RUTMIIT/hackathon/3D/STEP_ROS/уголок.stp

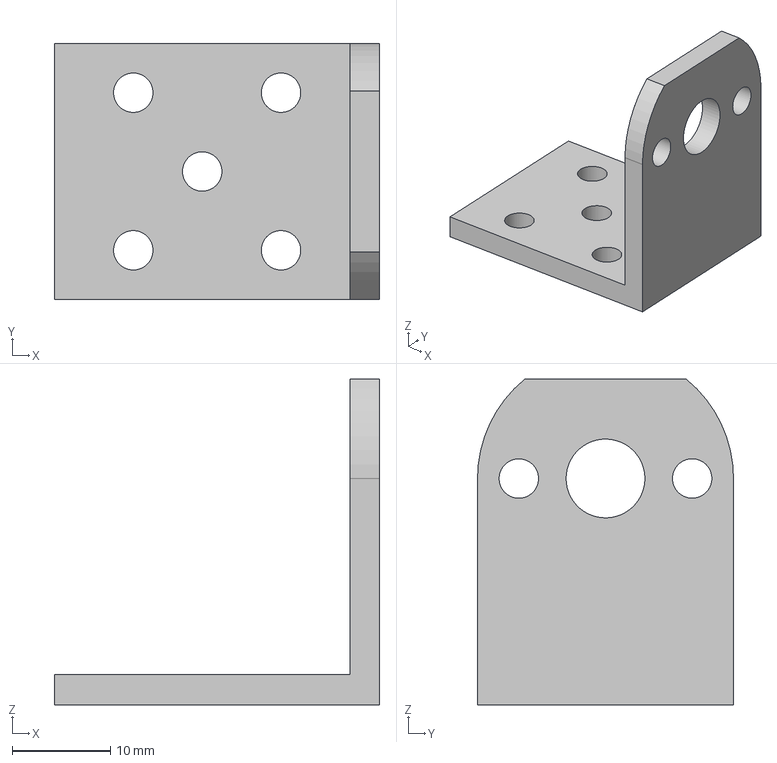
[picture p12: CAD file, 2025-04-05]
3D/STEP_ROS/уголок.stp
33.0 x 26.0 x 33.1 mm
