RUTMIIT/hackathon/3D/STEP_ROS/Сервопривод mg996r.stp

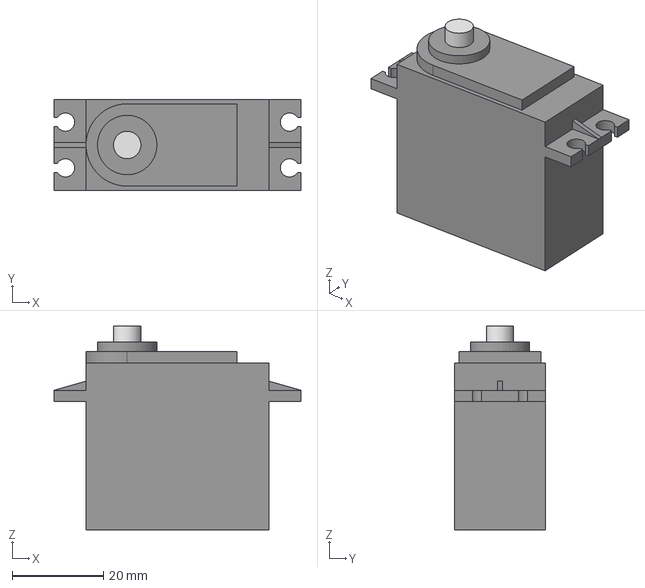
[picture p13: CAD file, 2025-04-05]
3D/STEP_ROS/Сервопривод mg996r.stp
54.0 x 20.0 x 44.5 mm
