RUTMIIT/hackathon/3D/STEP_ROS/Проставка 20 мм.stp

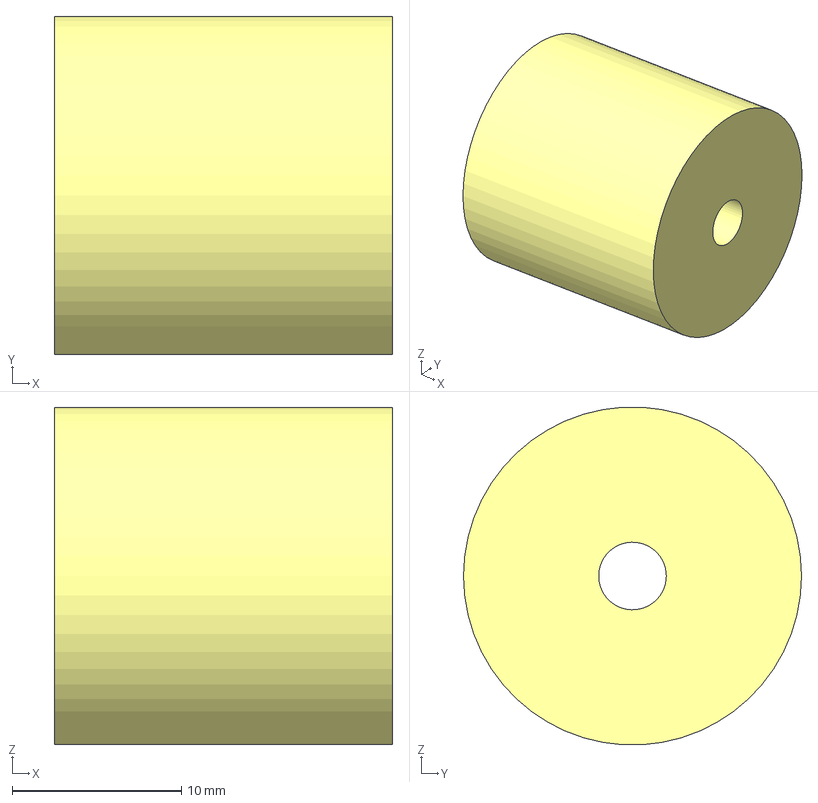
[picture p14: CAD file, 2025-04-05]
3D/STEP_ROS/Проставка 20 мм.stp
20.0 x 20.0 x 20.0 mm
