RUTMIIT/hackathon/3D/STEP_ROS/Кронштейн сервопривода вращения.stp

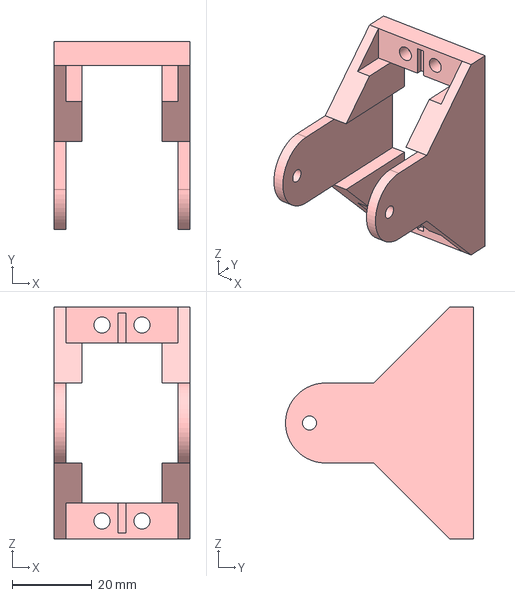
[picture p15: CAD file, 2025-04-05]
3D/STEP_ROS/Кронштейн сервопривода вращения.stp
34.0 x 47.0 x 58.0 mm
