RUTMIIT/hackathon/3D/STEP_ROS/Проставка 8 мм X2.stp

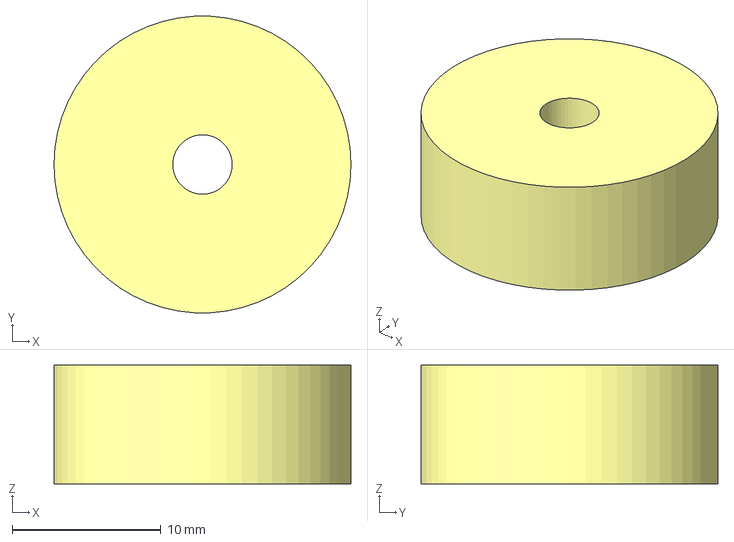
[picture p16: CAD file, 2025-04-05]
3D/STEP_ROS/Проставка 8 мм X2.stp
20.0 x 20.0 x 8.00 mm
