RUTMIIT/hackathon/3D/STEP_ROS/Кронштейн серво-станина X2.stp

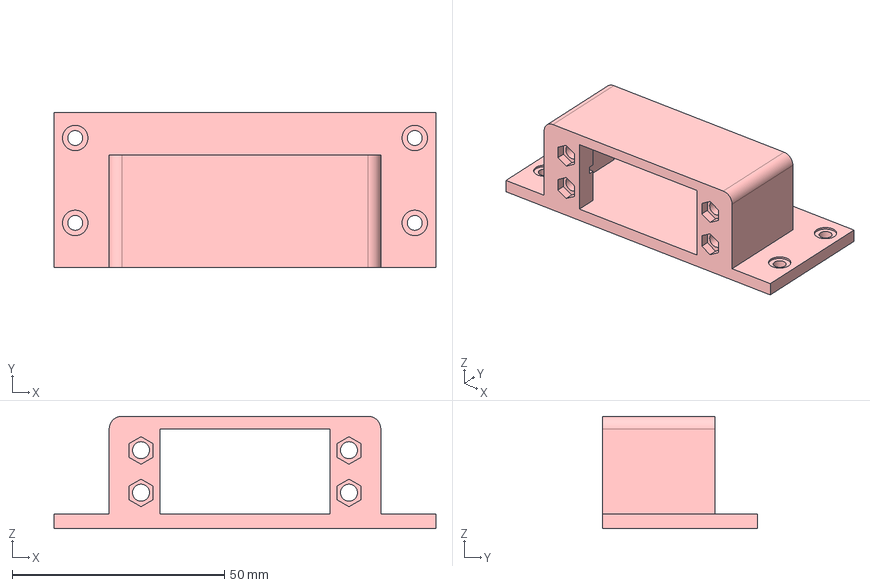
[picture p17: CAD file, 2025-04-05]
3D/STEP_ROS/Кронштейн серво-станина X2.stp
90.0 x 36.5 x 26.5 mm
