RUTMIIT/hackathon/3D/STEP_ROS/Платформа.stp

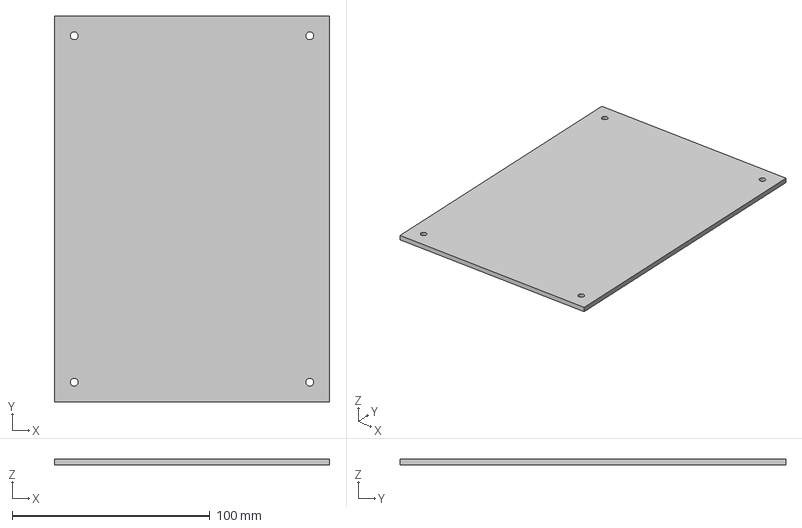
[picture p18: CAD file, 2025-04-05]
3D/STEP_ROS/Платформа.stp
139.0 x 195.0 x 3.00 mm
