RUTMIIT/hackathon/3D/STEP_ROS/Проставка тяга.stp

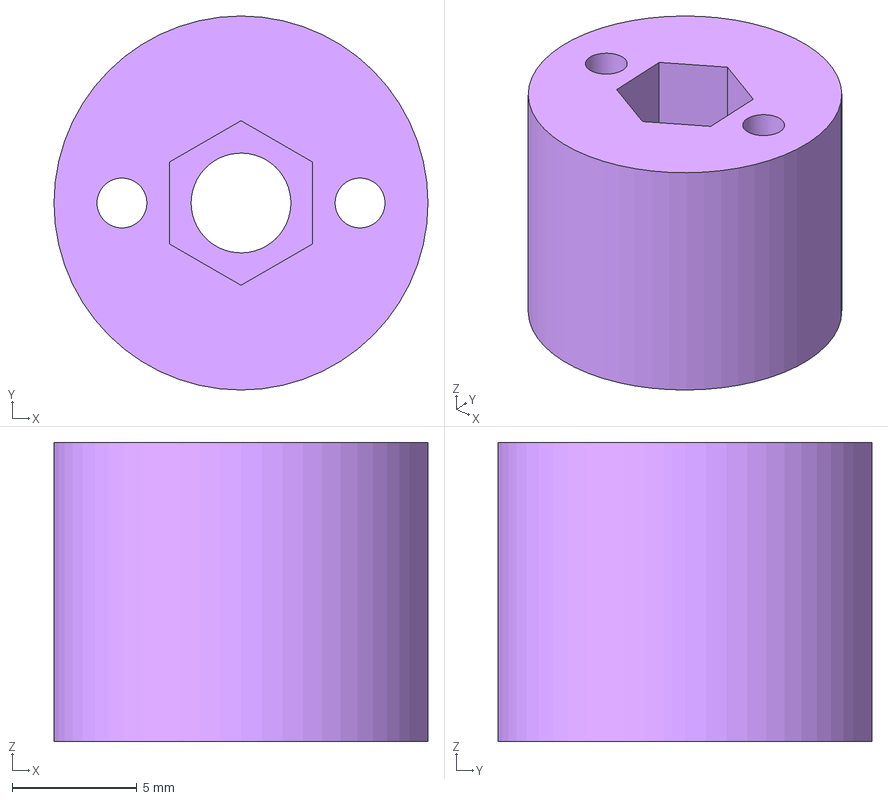
[picture p19: CAD file, 2025-04-05]
3D/STEP_ROS/Проставка тяга.stp
15.0 x 15.0 x 12.0 mm
