RUTMIIT/hackathon/3D/STEP_ROS/Звено 1 обычное.stp

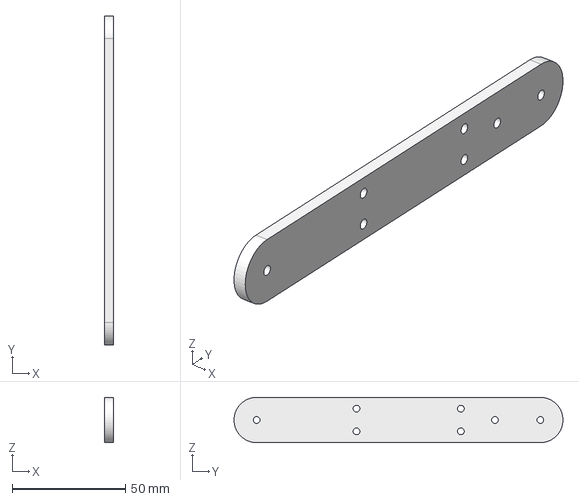
[picture p20: CAD file, 2025-04-05]
3D/STEP_ROS/Звено 1 обычное.stp
4.00 x 145.0 x 20.0 mm
