RUTMIIT/hackathon/3D/STEP_ROS/Станина.stp

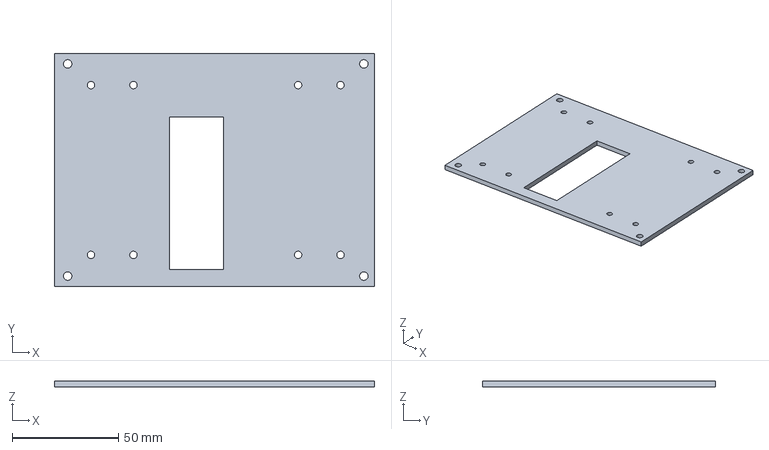
[picture p21: CAD file, 2025-04-05]
3D/STEP_ROS/Станина.stp
150.8 x 110.0 x 3.00 mm
