RUTMIIT/hackathon/3D/STEP_ROS/Крыльчатка большая.stp

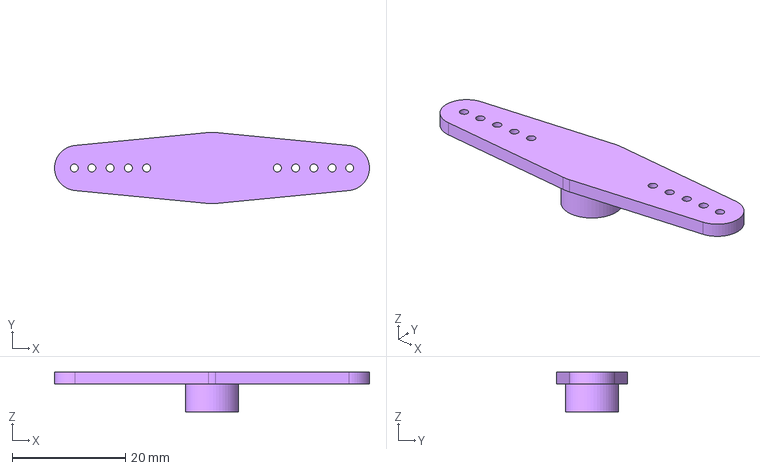
[picture p22: CAD file, 2025-04-05]
3D/STEP_ROS/Крыльчатка большая.stp
55.6 x 12.6 x 7.00 mm
