RUTMIIT/hackathon/3D/STEP_ROS/Проставка 2 мм X2.stp

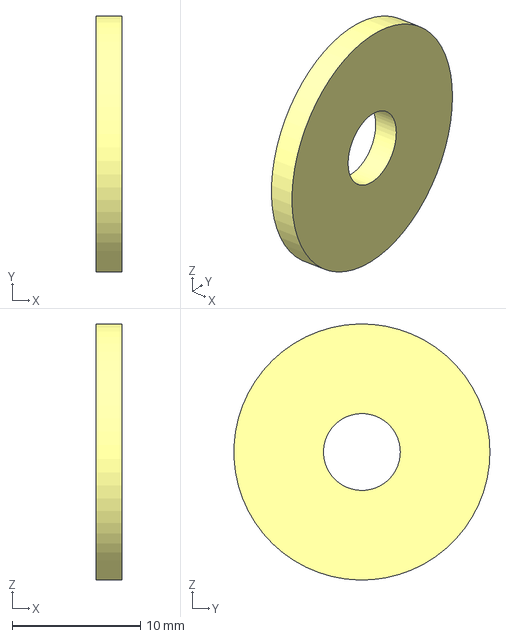
[picture p23: CAD file, 2025-04-05]
3D/STEP_ROS/Проставка 2 мм X2.stp
2.00 x 20.0 x 20.0 mm
