RUTMIIT/hackathon/3D/STEP_ROS/Крыльчатка маленькая.stp

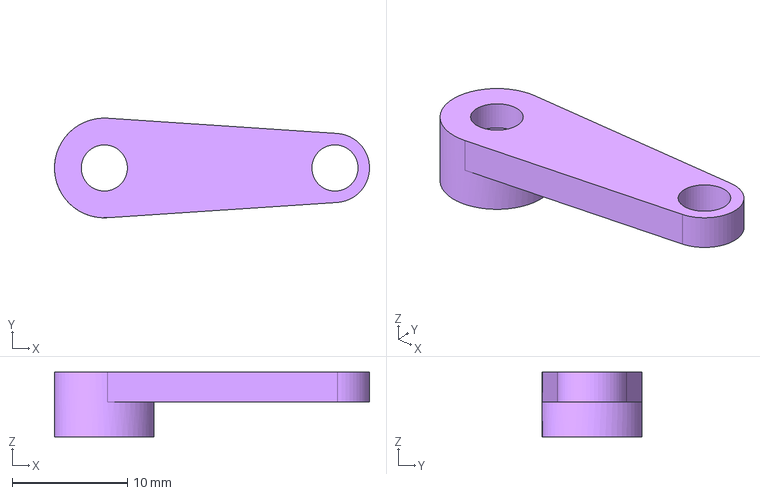
[picture p24: CAD file, 2025-04-05]
3D/STEP_ROS/Крыльчатка маленькая.stp
27.3 x 8.64 x 5.60 mm
