RUTMIIT/hackathon/3D/STEP_ROS/Звено захвата X2.stp

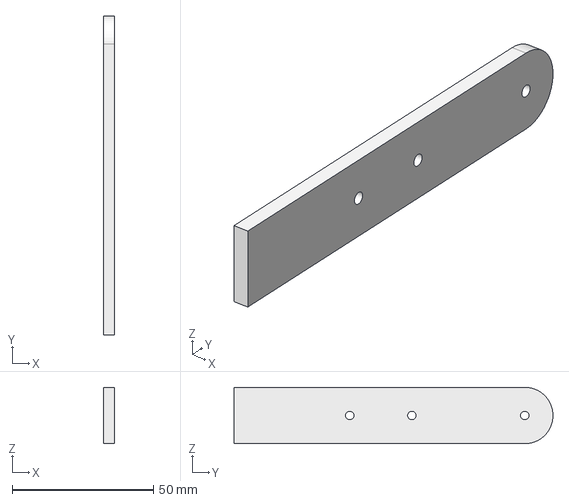
[picture p25: CAD file, 2025-04-05]
3D/STEP_ROS/Звено захвата X2.stp
4.00 x 113.0 x 20.0 mm
