RUTMIIT/hackathon/3D/STEP_ROS/Ферма.stp

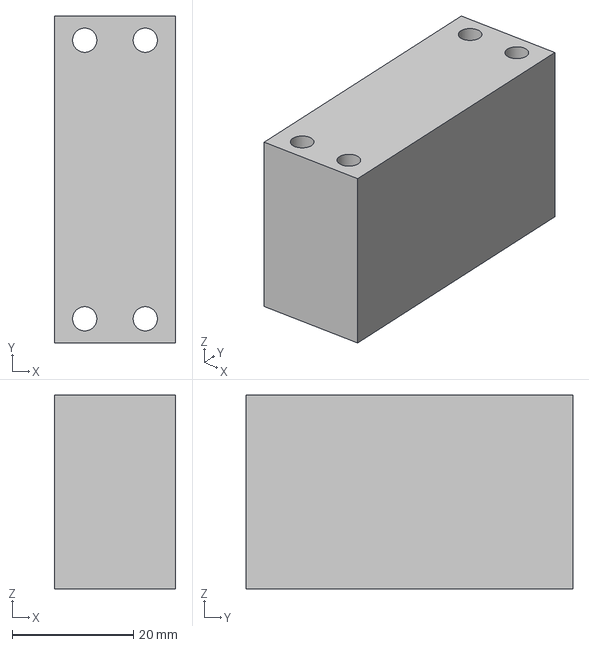
[picture p26: CAD file, 2025-04-05]
3D/STEP_ROS/Ферма.stp
20.0 x 54.0 x 32.0 mm
