RUTMIIT/hackathon/3D/STEP_ROS/Звено тяги.stp

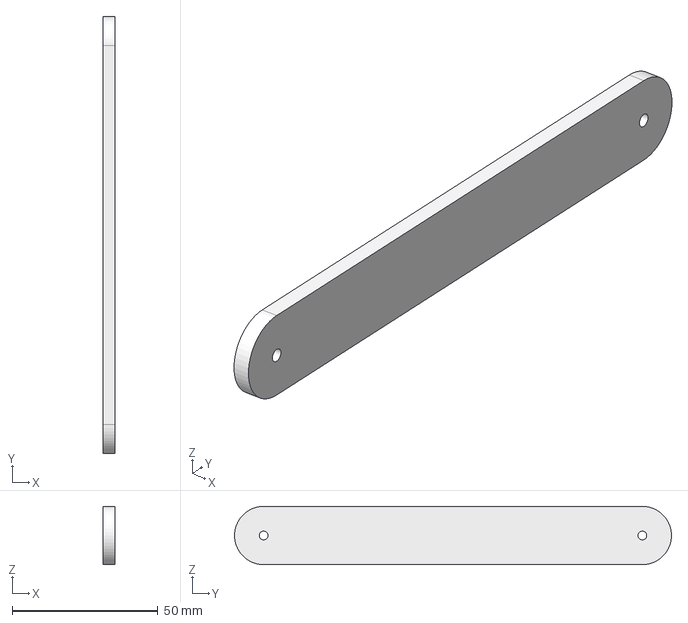
[picture p27: CAD file, 2025-04-05]
3D/STEP_ROS/Звено тяги.stp
4.00 x 150.0 x 20.0 mm
