RUTMIIT/hackathon/(list of files, cad)

Other CAD files:
3D/STEP_ROS/Звено 1 с широким отверстием.stp
